ksasao/pressure-monitor/docs/assets/images/esp32c3-bmp581/schematic-v1.0.webp

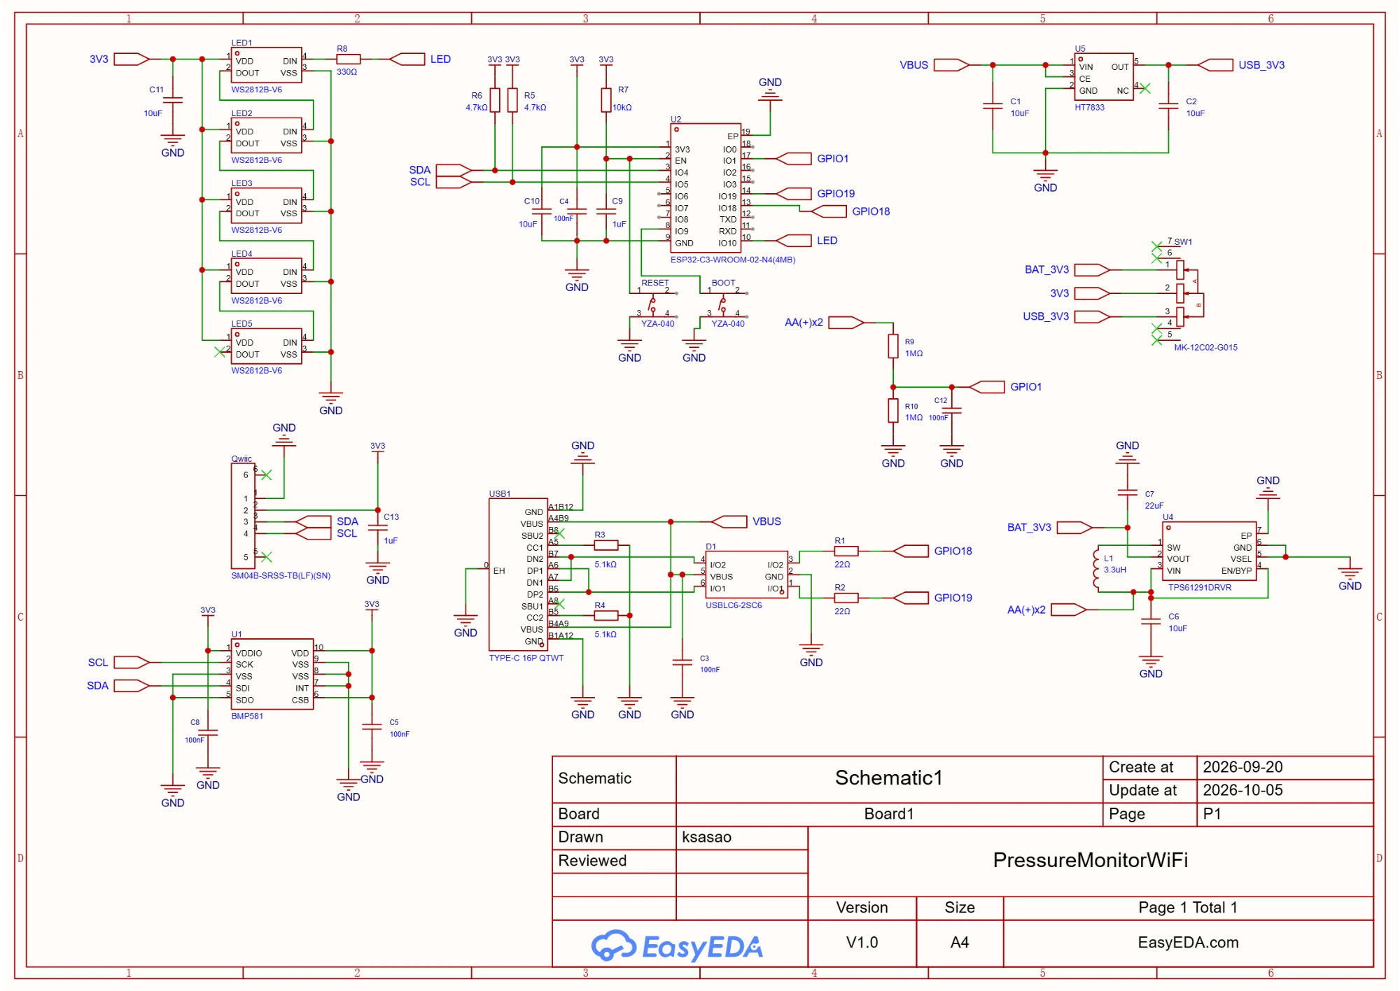
docs/assets/images/esp32c3-bmp581/schematic-v1.0.webp
