ksasao/pressure-monitor/docs/esp32c3-bmp581/faq/index.md

---
layout: default
title: よくある質問
---

# よくある質問

[esp32c3-bmp581 のページへ戻る](../)

## 何を検出しているのですか？

気圧の揺らぎを検出しています。

## LED の色は何を表しているのですか？

気圧が基準値を下回るとオレンジ、上回ると青で表示します。基準値との差が大きいほど、LED は明るく点灯します。

より正確には、気圧の値（絶対圧）を 1 次ハイパスフィルタに通した出力を表示しています。基準値は、ゆっくりとした気圧の変化に追従して更新されます。

## フレームレートはどのくらいですか？

30 FPS です。

## 5 個の LED は、それぞれ何を表しているのですか？

直近 5 フレームの履歴を表示しています。LED1 が最新のフレームで、後ろの LED ほど過去の状態を表します。履歴を並べて表示するだけで、揺らめくような動きになります。

## 気圧センサには何を使用していますか？

Bosch 製の高精度気圧センサ BMP581 を使用しています。

出力の最小単位（分解能）は 1/64 Pa です。なお、1 Pa は、地表付近でおよそ 8 cm の高度差に相当します。

## ESP32 は、消費電力が大きいのではありませんか？

ESP32-C3 は、Wi-Fi を使用せず、CPU クロックを下げて動作させることで、消費電力を小さく抑えられます。本機は CPU クロックを 80 MHz で動作させ、USB が接続されていない電池駆動のときは、LED が消えている間、ライトスリープで待機するため、動作中に触れても、ほとんど熱を感じません。

## 電源には何を使用しますか？

持ち運びしやすいよう、単三電池 2 本で動作します。エネループ（ニッケル水素電池）なども使用できます。USB-C から給電することもできます。USB-C をつなぐと、自動で USB からの給電に切り替わります。基板上のスライドスイッチは、電池の電源スイッチです（2026-10-05 版の基板では、電池と USB を切り替えるスイッチです）。

充電機能はありません。なお、リチウムイオン電池は、取り扱いを誤ると発熱や発火のおそれがあるため、安全面を考慮して採用していません。

## モバイルバッテリーで使用できますか？

USB-C からモバイルバッテリーで給電できます。ただし、**「低電流モード」（微弱電流モード、IoT モードなどの名称）に対応した製品を推奨します。**

モバイルバッテリーの多くは、出力電流が小さい状態が続くと、負荷がつながっていないとみなして、出力を止めます。本機は、LED が消えているとき、省電力のために電流が約 1 mA まで下がるため、低電流モードに対応していない製品では、数分で給電が止まることがあります。低電流モードに対応した製品では、止まらないことを確認しています。

## ファームウェアを書き込むのに、ドライバは必要ですか？

ほとんどの環境で、不要です。本機は、ESP32-C3 に内蔵の USB をそのまま使っており、USB シリアル変換 IC（CP210x、CH340 など）を載せていないため、OS に標準で入っているドライバで動作します。

| OS | ドライバ | 補足 |
|---|---|---|
| Windows 10 / 11 | 不要 | 「USB シリアル デバイス (COMx)」として認識されます。デバイスマネージャーに「USB JTAG/serial debug unit」が「！」付きで表示されることがありますが、デバッグ用のもので、書き込みには関係ありません |
| macOS | 不要 | 「cu.usbmodem…」として認識されます |
| Linux | 不要 | ポートを使う権限が必要です。`sudo usermod -a -G dialout $USER` を実行して、ログインし直してください（Arch Linux では `uucp` グループ） |
| ChromeOS | 不要 | |

Windows 8.1 以前は、書き込みツールに必要な Chrome / Edge が対応していないため、使えません。ポートが表示されないときは、[書き込みツール](../flasher/)の「ポートが表示されないとき」をご覧ください。
