ksasao/pressure-monitor/firmware/esp32c3-bmp581/version.h

/*
 * version.h - ファームウェアのバージョン (リリース日)
 *
 * リリースのスクリプト (tools/release.mjs) が書き換えます。手で編集する必要はありません。
 * 形式は "YYYY-MM-DD"。同じ日に 2 回以上リリースしたときは "YYYY-MM-DD.2" のようになります。
 * リリースの後に手元でビルドしたものも、次のリリースまでは、同じバージョンを表示します。
 */
#pragma once

#define FIRMWARE_VERSION "2026-11-12"
