ksasao/pressure-monitor/firmware/esp32c3-bmp581/button.cpp

#include "button.h"

#include <Arduino.h>

Button::Button(uint8_t pin, uint32_t longPressMs, uint32_t veryLongMs)
    : pin_(pin), longPressMs_(longPressMs), veryLongMs_(veryLongMs)
{
}

void Button::begin()
{
    pinMode(pin_, INPUT_PULLUP);
}

ButtonEvent Button::poll()
{
    uint32_t    now   = millis();
    bool        down  = (digitalRead(pin_) == LOW);
    ButtonEvent event = BTN_NONE;

    if (down && !prevDown_) {
        downAt_    = now;
        longFired_ = false;
        veryLongFired_ = false;
    }

    if (down && !longFired_ && (now - downAt_) >= longPressMs_) {
        longFired_ = true;
        event      = BTN_LONG_REACHED;
    }

    if (down && !veryLongFired_ && (now - downAt_) >= veryLongMs_) {
        veryLongFired_ = true;
        event          = BTN_VERY_LONG_REACHED;
    }

    if (!down && prevDown_) {
        if (veryLongFired_) {
            event = BTN_NONE;                   // 処理は BTN_VERY_LONG_REACHED で済んでいる
        } else if (longFired_) {
            event = BTN_LONG_RELEASED;
        } else if ((now - downAt_) > 40) {      // チャタリング対策
            event = BTN_SHORT;
        }
    }

    prevDown_ = down;
    return event;
}

bool Button::isDown() const
{
    return digitalRead(pin_) == LOW;
}
