ksasao/pressure-monitor/firmware/esp32c3-bmp581/hub_page.h

/*
 * hub_page.h - ハブの表示ページ (HTML とスクリプト)
 *
 * スマホのブラウザで開くページです。WebSocket (/ws) で受け取ったフレーム (hub.h) を読み、
 * 装置ごとに、LED の色、HPF の出力のグラフ、気圧、電池電圧、電波の強さ、欠落率を表示します。
 *
 * 記録: 「記録を開始」を押すと、受け取ったサンプルを、ブラウザの中 (IndexedDB) に保存します。
 * ページを再読み込みしても残り、「CSV を保存」で、まとめてダウンロードできます。
 * 時刻は、ハブの millis をスマホの時計に合わせた値です (数十 ms の誤差があります)。
 */
#pragma once

extern const char HUB_PAGE_HTML[];
