ksasao/pressure-monitor/(commit log)

2026-10-05 ESP32-C3 + BMP581 版と GitHub Pages の資料を追加
    - firmware/esp32c3-bmp581: Arduino スケッチと README
    (気圧のハイパスフィルタ出力を LED 5 個の履歴として表示、電池電圧を 1 分ごとに出力)
    - hardware/esp32c3-bmp581: 製造データ置き場の案内
    - docs: GitHub Pages 用の資料 (トップ、版ごとの説明、FAQ、回路図、デモ GIF)
    - README: 概要、実装一覧、クイックスタート、デモ GIF
    - .gitignore
2026-10-05 esp32c3-bmp581 のページ冒頭に説明文とデモ GIF を追加
2026-10-05 FAQ へのリンクの文を修正
2026-10-07 ファームウェアをモジュール分割し、省電力・設定モードを追加
    - ソースを機能ごとのファイルに分割 (config / settings / sensor / display / power など)
    - HighPassFilter、Button、SerialLog、PerfStats をクラス化 (Qwiic の追加センサを想定)
    - 設定モード (Wi-Fi + キャプティブポータル + 非同期 Web サーバ) を追加
    - USB 未接続かつ全消灯のときだけライトスリープ、内容が同じなら LED へ送らない
    - ライトスリープ復帰直後に LED が一瞬緑になる問題を、CPU 80MHz で解消
    - 診断用の全点灯モード (モード 3) を追加
    - キャプティブポータル検証用ス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
2026-10-08 LED の電流の上限を、明るさの最大値 (0～255) の設定に置き換え
    - 設定ページの項目を「電流の上限 (mA)」から「明るさの最大値」に変更 (既定 255)
    - FastLED の電流による制限は外し、setBrightness() で明るさを抑える
    - 電流は別途実測してから、必要なら制限を入れ直す
    - README を更新
2026-10-09 表示モードを4種類にし、設定ページをリアルタイム反映に、電池電圧を CSV に出力
    - BOOT ボタンで、標準 / ドライブ / カスタム / 固定色 の4モードを切り替え
    (番号の数だけ LED を2秒間青で点灯。その間に続けて押すと次のモード。選んだモードは保存)
    - 設定ページ: スライドバーと数値の両方で指定、LED へリアルタイムに反映、表示モードのボタン
    - 固定色モード (HSV) を追加。気圧バー、消灯、全点灯(診断用)のモードは廃止
    - 電源投入時に、できるだけ速やかに白で全点灯してから、自己診断に進む
    - 電池電圧を、#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
2026-10-09 設定ページのリアルタイム反映を WebSocket にし、色見本を削除
    - 値の送信を WebSocket (/ws) に変更。応答を待たずに、1 秒に 30 回まで送る
    (WebSocket が使えないときは、従来の HTTP POST /live に自動で切り替え)
    - 固定色の色見本を削除 (画面より LED が明るく見えるため、LED で確認する)
    - 無操作タイムアウトの判定が、受信タスクとの競合で、10 分たたずに誤って
    発動する問題を修正 (経過時間を符号付きで比較。変数は volatile に)
    - 再起動の原因を調べやすいよう、BOOT 長押しと「保存して終了」のログ行を追加
    Co-Authored-By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
    [esp32c3-bmp581.ino, portal.cpp, settings_page.cpp]
2026-10-11 複数台の表示 (ESP-NOW のハブ) を追加
    - 設定ページで、役割 (単体 / 送信 / ハブ) と装置の番号を選べるようにした
    - 送信の装置は、30Hz のサンプルを 3 個ずつまとめて、ESP-NOW のブロードキャストで送る
    - ハブは、受信したデータを WebSocket でスマホのブラウザへ送り、装置ごとにグラフや
    欠落率を表示する。ブラウザの中 (IndexedDB) に記録し、CSV で保存できる
    - ハブは、既存の Wi-Fi (ルーター) に接続できる。つながらなければ、自分でアクセスポイントになる
    - ハブのビーコンで、送信の装置がハブのチャンネルを自動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
2026-10-12 初期化の長押し、装置の名前、グループ番号、ハブのチャンネル、グラフの並べ替えを追加
    - BOOT ボタンを 20 秒押し続けると、全ての LED を赤で 1 秒間点滅したあと、
    設定を全て初期値に戻し、ボタンを離すと再起動する
    - 装置の番号を、装置の名前に変えた。初期値は ps- と MAC アドレスの下 6 桁
    (UTF-8 で 16 バイトまで)。パケットに名前を載せ、CSV に name と mac の列を追加
    - ESP-NOW のグループ番号 (1〜255、初期値 39) を追加。同じ番号の送信の装置と
    ハブだけがやり取りする
    - ハブが自分でアクセスポイントになる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
2026-10-12 設定モードの最初のページを気圧の表示にし、固定色モードに気圧の変化の反映を追加
    - 設定モードで最初に開くページを、気圧の絶対値と変化量を大きく表示し、グラフを画面いっぱいに
    描くページにした (monitor_page)。横向きでは数値を 1 行にまとめてグラフを広くする。
    グラフは変化量と気圧、10 秒と 60 秒を切り替えられる。各種の設定は「設定」ボタンから開く
    - 表示ページに、記録 (IndexedDB)、CSV の保存、消去のボタンを追加
    - 基板は、30Hz のサンプルを約 100ms ごとにまとめて、WebSocket で表示ページへ送る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
2026-10-12 ブラウザの書き込みツールと、リリースの手順を追加
    - docs/esp32c3-bmp581/flasher/: esptool.js で、ブラウザ (Web Serial) から書き込むツール。
    バージョン (リリース日) を選べる。ファイルごとに SHA-256 を確かめてから書き込む
    - tools/release.mjs: version.h を更新し、arduino-cli でビルドして、docs にバイナリと
    リリースの一覧を置くスクリプト。tools/serve-docs.mjs: docs を localhost で公開する
    - RELEASING.md: Arduino IDE での確認から公開までの手順
    - version.h を追加し、ファームウェアのバージョンを、起動時のシリアル、設定ページ、
    ハブ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
2026-10-12 リリース 2026-10-12 に、ビルド元のコミット (3b9da6c) を記録
2026-10-13 書き込みツールと FAQ に、ドライバの説明を追加
    - 本機は ESP32-C3 内蔵の USB を使うため、Windows 10/11、macOS、Linux、ChromeOS では
    ドライバのインストールが不要であることを説明した (Linux はポートの権限の設定だけ)
    - ポートが表示されないときの対処 (ケーブル、Zadig で入れ替えたドライバの戻し方) を追加
    - 参考として、USB シリアル変換 IC (CP210x、CH340、FTDI) のドライバの配布先を記載
2026-10-18 基板の中への記録を追加 (Android のログイン画面で CSV を保存できるように)
    - 気圧のサンプル (30Hz) を、基板のフラッシュに記録し、/log.csv からダウンロードする。
    Android の Wi-Fi のログイン画面は blob: を保存できないため、基板が CSV を返す方式にした
    - 差分を詰めた形式 (約 3.3 バイト/サンプル) と、フラッシュの割り当て (partitions.csv、
    No OTA と同じ。Arduino IDE の Partition Scheme より優先) で、約 5.5 時間記録できる
    - 変化量は記録せず、CSV を作るときに、基板と同じ HPF で気圧から求め直す
    - 「記録して Wi-Fi をオフ」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
2026-10-18 ファームウェア 2026-10-19 をリリース (esp32c3-bmp581)
    - 基板の中への記録 (最長 約 5.5 時間) を含む版。ビルド元は ee2f685
    - フラッシュの割り当てが変わる (記録用の領域を作る)。設定は書き込み後も残る
2026-10-21 記録の改善 (間隔の選択、電池電圧、装置の情報) と、点灯中のライトスリープ
    - LED が点灯している間も、ティックの待ち時間にライトスリープに入る
    (LIGHT_SLEEP_WHILE_LIT)。WS2812B は、データを受け取ったあとは色を保つため。
    風の強い日など、点灯している時間が長いときの電池の持ちを延ばす。
    眠った後の 2 回の送信は LED_RESEND_AFTER_WAKE で切り替えられる
    - 基板の中への記録の間隔を、1/30 秒・1 秒・30 秒から選べるようにした。
    1 秒と 30 秒は、その間の気圧・温度・変化量の平均を記録する
    (約 39 時間、約 48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
2026-10-21 ファームウェア 2026-10-21 をリリース (esp32c3-bmp581)
    - 点灯中のライトスリープ、記録の間隔の選択、電池電圧と装置の情報の記録、
    記録前の役割の確認を含む版。ビルド元は 8694ec6
    - CSV の形式が変わる (1 行目がコメント、battery_mV の列を追加)
2026-10-26 音 (Modulino Buzzer)、ドライブモードの見直し、iPhone での CSV の保存
    - Qwiic の Modulino Buzzer で、LED の色 (気圧の変化) に合わせて、コード進行の
    アルペジオを鳴らす (sound.h / .cpp)。不感帯では無音
    - + は明るい C メジャー、- は暗い C マイナーの 8 小節の進行
    - 変化の大きさと続いている時間で、5 段階に豪華にする (三和音 → 7 度 → 9 度、
    音の数、速さ、音域)。瞬間的な変化では、速い駆け上がり
    - 短い無音では進行の続きから鳴らし、鳴り始めごとに高さと形を変える
    (弱い変化で、同じ音が続かないように)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
2026-10-26 ファームウェア 2026-10-27 をリリース (esp32c3-bmp581)
    - 音 (Modulino Buzzer)、ドライブモードの見直し、iPhone での CSV の保存、
    「Wi-Fi を切る」ボタンを含む版。ビルド元は 71afaaa
2026-10-31 センサの間隔での記録 (30Hz・32 倍、FIFO)、記録の詰め直し、CSV の速い保存
    - センサ (BMP581) を 30Hz・オーバーサンプリング 32 倍にし、FIFO に値をためる。
    基板は 33ms ごとに、たまった値を全て読み、1 個ずつ処理する (重複・読み落としなし)。
    1 サンプルのノイズは 約 0.18 Pa から 約 0.12〜0.14 Pa に (sensor.h / .cpp)
    - 記録の形式を版 6 にする (devlog.h / .cpp)
    - 1/30 秒: センサの間隔のまま、気圧の差だけを詰める (約 1.1 バイト/サンプル)。
    最長 約 5.5 時間 -> 約 16 時間。時刻は、読んだ時刻の下側の線 (遅れがほぼ 0 の点を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
2026-10-31 ファームウェア 2026-10-31 をリリース (esp32c3-bmp581)
2026-10-31 FIFO の値の抜けと記録の始めの時刻を修正、シリアルから BOOT ボタンの操作
    - FIFO には気圧だけをためる (32 個、約 1 秒分)。気圧と温度の組では 16 個 (約 0.5 秒分)
    しか入らず、設定モードで処理が止まると値が抜け、センサの間隔を 1% 誤って、時刻が
    最大 約 380ms ずれていた。温度は約 1 秒ごとにレジスタから読む (sensor.cpp)
    - 値の抜けを、読んだ時刻の飛びでも検出する。実測したあとのセンサの間隔から ±0.05% を
    超えて離れた値は使わない。フレームの先頭の時刻を、前のフレームより前にしない
    - 記録を始め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
2026-10-31 ファームウェア 2026-10-31 を差し替え (esp32c3-bmp581)
    FIFO の値の抜けと記録の始めの時刻の修正、シリアルからの BOOT ボタンの操作を含める (b86e254)
2026-10-31 シリアルから BOOT ボタンの操作を送るスクリプト (tools/serial-command.py)
    試験用に使っていたスクリプトを、引数とヘルプのある形にして tools/ に置く。tools/README.md に、tools のスクリプトの一覧と、使い方を書く。
2026-10-31 シリアルから、状態の表示と、記録の開始・停止・消去・保存
    - status: 今の設定、Wi-Fi・ESP-NOW の状態、基板の中の記録の量などを、
    "# status 名前=値" の行でまとめて出す (Wi-Fi のパスワードは出さない)
    - start <間隔ms> <時刻ms> <タイムゾーン> / stop <時刻ms> / clear: 記録の操作。
    通常モードで start したときは、再起動せずに、そのまま記録する
    - dump: 記録を /log.bin と同じ形で、CRC-32 を付けて送る (記録中は送らない)
    - tools/serial-command.py: status、start (--interval)、stop (PC の時計を送る)、
    save (dump を受け取り CSV にする。--bin、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
2026-10-31 ファームウェア 2026-10-31 を差し替え (esp32c3-bmp581)
    シリアルからの状態の表示と、記録の開始・停止・消去・保存を含める (018d512)
2026-10-31 書き込みツール: 書き込みのあと、基板をリセットして起動する
    esptool-js 0.6.0 の after("hard_reset") は RTS を離すだけで、リセットをかけないため、基板が書き込み用のプログラム (スタブ) のまま止まっていた。DTR を離したまま RTS を 0.1 秒かけてリセットする (resetToApp)。flasher.js の読み込みに版の印 (?v=) を付け、開いたときにツールの版をログに出す。
2026-11-01 記録の時刻の飛び、センサの間隔の保存、CSV のファイル名を修正
    - 記録の時刻を esp_timer から求める (devlog.cpp)。ライトスリープから戻るたびに、
    gettimeofday が RTC の時計に合わせ直され、電池で動かして 15 秒後の最初のライトスリープで
    時刻が 50〜70ms 飛んでいた。gettimeofday は、記録の開始と再開のときだけ読む (syncRelClock)
    - 実測したセンサの間隔を NVS に保存し、電源を入れたときは、保存した値から始める
    (0.01% 以上変わったときだけ、10 分に 1 回まで書く。settings.h / .cpp のキー sper)
    - 保存した値がないときは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
2026-11-01 ファームウェア 2026-11-01 をリリース (esp32c3-bmp581)
    記録の時刻の飛び、センサの間隔の保存、CSV のファイル名の修正を含める (4d5ae15)
2026-11-01 ドライブモード: 色の目盛りを対数にする (4〜400 Pa)
    - 10/31 の 1/30 秒間隔の記録 (約 14 時間) では、乗り物の中の変化は、歩行や高度のゆっくりした変化の
    数 Pa から、新幹線がトンネルを出入りするときの ±200〜400 Pa まで、100 倍ほど違った。
    これまでの線形の目盛り (4〜64 Pa) では、新幹線の中の 3 割の時間が白になり、それ以外の場面は、
    ほとんど消灯か暗い色だった
    - ドライブモードの感度の上限を 4096 (約 64 Pa) から 25600 (約 400 Pa) にし、色を limit〜range の
    比の対数で決める (約 4 -> 19 -> 86 -> 400 Pa で、暗い色 -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
2026-11-01 ファームウェア 2026-11-01 を差し替え (esp32c3-bmp581)
    ドライブモードの色の目盛りを対数にする変更を含める (fc3b43e)
2026-11-10 docs(esp32c3-bmp581): お問い合わせフォームへのリンクを追加
2026-11-10 docs(esp32c3-bmp581): 見出しの製品名を「気圧ゆらぎセンサ開発ボード」に変更
2026-11-10 docs(esp32c3-bmp581): 回路図を V1.1 にし、ページを今の基板とファームウェアに合わせる
    - 回路図を 2026-10-26 版 (V1.1) に差し替え、V1.0 を schematic-v1.0.webp として残す
    - 回路の構成、電源、制約の節を、TPS2116 による自動の切り替えと SW1 (電池の電源スイッチ) に合わせて書き直す
    - 内容物と仕様の節を追加
    - 基板の中への記録、複数台の表示、音 (Modulino Buzzer)、ドライブモードの対数の目盛りの説明を追加
    - FAQ、firmware と hardware の README の電源と電池電圧の記載を V1.1 に合わせる
2026-11-10 docs(esp32c3-bmp581): 外観の写真（斜め・表面・裏面）を追加
2026-11-10 docs(esp32c3-bmp581): 外観の写真を縮小して軽くする
2026-11-10 .gitignore に Python のキャッシュ（__pycache__/）を追加
2026-11-10 docs(esp32c3-bmp581): 裏面の写真を 1000×1000px にして表面とそろえる
2026-11-10 独自に開発する方向けのサンプル (esp32c3-bmp581-basic) を追加
    - 気圧と温度 (BMP581)、BOOT ボタン、LED (WS2812B × 5)、電池電圧、電源の状態 (IO3) の使い方を、短い関数にまとめた Arduino スケッチ
    - LED はボードパッケージの RMT で点灯し、FastLED を使わない (ビルドを速くするため)
    - シリアルの出力で待たないように、Serial.setTxTimeoutMs(0) にする
    - README とサポートページから、サンプルへリンクする
2026-11-10 esp32c3-bmp581-basic: Qwiic コネクタが BMP581 と同じ I2C バスである旨を追記
2026-11-10 AI でファームウェアを書き換える方向けのページと、AI に渡す基板の情報を追加
    - firmware/esp32c3-bmp581-basic/AGENTS.md: ピン割り当て、開発環境、ボードパッケージ 3.x の書き方、シリアルの注意 (DTR/RTS) などをまとめた、AI 向けの基板の情報。CLAUDE.md から読み込む
    - docs/esp32c3-bmp581/vibe-coding/: 進め方、頼み方の例、うまくいかないとき
    - 独自に書き換えたファームウェアの動作は、サポートの対象外である旨を記載
    - サポートページとサンプルの README から、リンクする
2026-11-12 docs: お問い合わせフォームのリンクを短縮 URL（ksasao.github.io/p/contact）にする
2026-11-12 esp32c3-bmp581: USB の給電 (IO3 の ST) で眠りから起き、挿した USB がすぐに認識されるようにする
    電池で眠っているときに USB を挿すと、5 秒ごとの検出窓 (400ms) でしか応答できず、
    Windows が認識に失敗することがあった。V1.1 の基板は TPS2116 の ST を IO3 で読めるので、
    USB から給電されている間は眠らず、眠っている間に給電が始まったら GPIO で起きる。
    IO3 が未接続の V1.0 の基板は、起動時に見分けて、今までどおりの動作にする。
2026-11-12 ファームウェア 2026-11-12 をリリース (esp32c3-bmp581)
2026-11-12 tools: 出荷前検査のスクリプト (shipping-test.py) を追加
2026-11-13 docs: 写真の EXIF（撮影場所の位置情報など）を削除
    画像のデータはそのままで、メタデータだけを取り除いた。
